sofia-kirilov/cyber_deck/lid_full.step

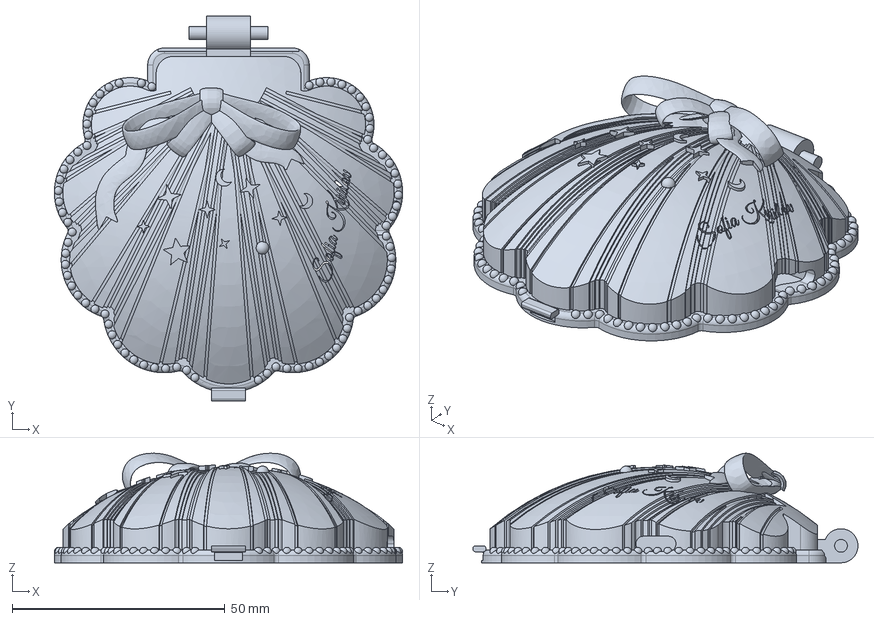
[picture p1: CAD file, 2026-10-19]
lid_full.step
81.9 x 90.5 x 25.8 mm
