sofia-kirilov/cyber_deck/lid.3mf

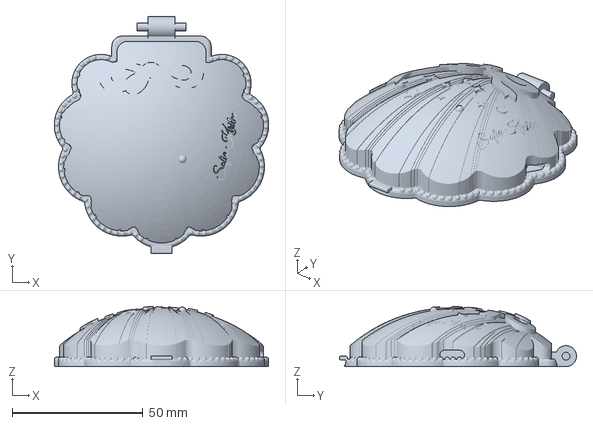
[picture p2: CAD file, 2026-11-02]
lid.3mf
81.9 x 90.5 x 23.0 mm
