sofia-kirilov/cyber_deck/bezel_plate.step

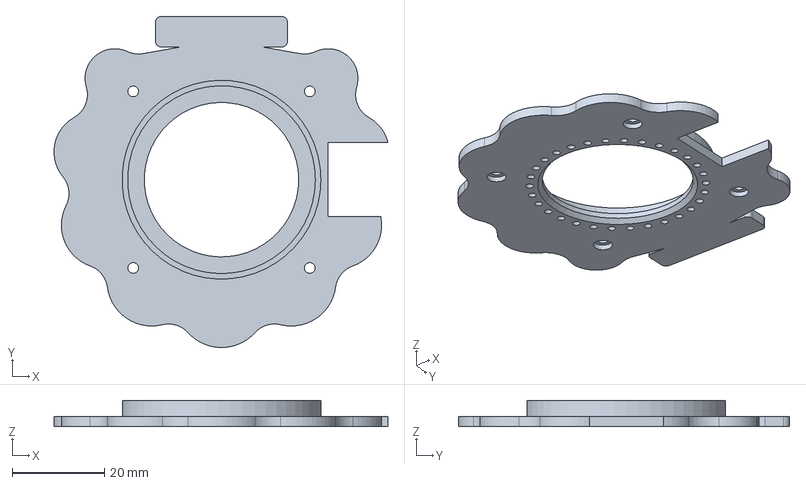
[picture p3: CAD file, 2026-10-19]
bezel_plate.step
72.2 x 71.6 x 5.70 mm
