sofia-kirilov/cyber_deck/base.step

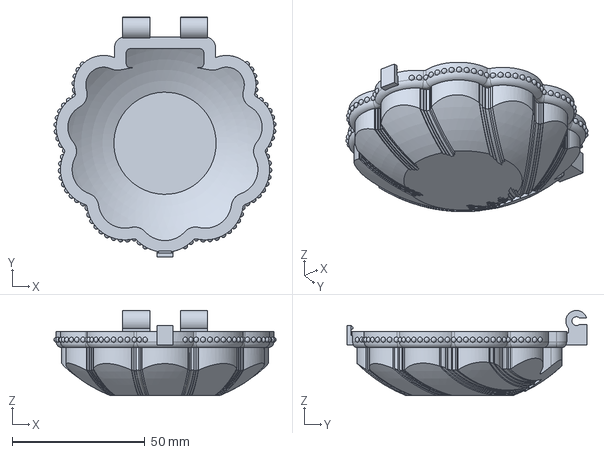
[picture p4: CAD file, 2026-10-19]
base.step
83.5 x 90.3 x 32.0 mm
