sofia-kirilov/cyber_deck/(list of files, cad)

Other CAD files:
base.3mf
base.stl
bezel_plate.3mf
bezel_plate.stl
lid.stl
